CircuitMonkey/synth-stepped-tone-generator/README.md

# synth-stepped-tone-generator
Sound synthesizer circuit for stepped tones. Based on a Forest Mimms III circuit design.
