CircuitMonkey/synth-stepped-tone-generator/Documents/stepped-tone-generator.ods

Stepped Tone Generator |  |  | Rev. A
Part | Value | Device | Package | Description | MFR | MPN | Cost | Have | Cart
FAB |  |  |  |  |  |  | $2.00 |  | Seeed
U1 | NE555P | 555PDIP | DIP-08 | Timer Chip | Tayda | A-249 | $0.15 |  | Tayda
U2 | NE556N | 556PDIP | DIP-14 | 556 Dual Timer | Tayda | A-040 | $0.37 |  | Tayda
U3 | CD4017BE | CD4017PDIP | DIP-16 | CD4017 Decade Counter | Tayda | A-020 | $0.30 |  | Tayda
U1-SKT | 8P |  | DIP-08 | Socket | Tayda | A-001 | $0.05 |  | Tayda
U2-SKT | 14P |  | DIP-14 | Socket | Tayda | A-004 | $0.07 |  | Tayda
U3-SKT | 16P |  | DIP-16 | Socket | Tayda | A-003 | $0.08 |  | Tayda
C1 | 10nF | CAPACITORTHD_5MM | CAP_CER_THD_5MM | Capacitor | Tayda | A-1366 | $0.04 |  | Tayda
C2 | 10nF | CAPACITORTHD_5MM | CAP_CER_THD_5MM | Capacitor | Tayda | A-1366 | $0.04 |  | Tayda
C3 | 10uF | CAPACITORTHD_5MM | CAP_CER_THD_5MM | Capacitor | Tayda | A-3323 | $0.03 |  | Tayda
C4 | 1uF | CAPACITORTHD_5MM | CAP_CER_THD_5MM | Capacitor | Tayda | A-321 | $0.12 |  | Tayda
PWR_AUX | 3P, Male, Breakaway, 2.54mm | CON_03X1-2.54MM-THD-VT | MA03X1 | Header, 3-pin, single row |  |  | $0.06 | Y
D1 | 1N4148 | DIODE-1N4148-THD | DO-35(THD) | Diode |  | A-157 | $0.02 |  | Tayda
D2 | 1N4148 | DIODE-1N4148-THD | DO-35(THD) | Diode |  | A-157 | $0.02 |  | Tayda
D3 | 1N4148 | DIODE-1N4148-THD | DO-35(THD) | Diode |  | A-157 | $0.02 |  | Tayda
D4 | 1N4148 | DIODE-1N4148-THD | DO-35(THD) | Diode |  | A-157 | $0.02 |  | Tayda
SPEAKER | 2inch | Speaker |  | Loudspeaker, 2in |  | A-4117 | $1.00 |  | Tayda
SPEAKER-CON | HDR, 2P | MA02-1VT | MA02-1-FAT | Header, 2-pin |  |  | $0.03 | Y
TRIM1 | 100K | POTRK09?113 | ALPS_RK09D113 | Potentiometer with solder mounts | Alps | A-1851 | $0.70 |  | Tayda
TRIM2 | 100K | POTRK09?113 | ALPS_RK09D113 | Potentiometer with solder mounts | Alps | A-1851 | $0.70 |  | Tayda
TRIM3 | 100K | POTRK09?113 | ALPS_RK09D113 | Potentiometer with solder mounts | Alps | A-1851 | $0.70 |  | Tayda
TRIM4 | 100K | POTRK09?113 | ALPS_RK09D113 | Potentiometer with solder mounts | Alps | A-1851 | $0.70 |  | Tayda
VOLUME | 10K | POTRK09?113 | ALPS_RK09D113 | Potentiometer with solder mounts | Alps | A-1850 | $0.70 |  | Tayda
SPEED | 500K | POTRK09?113 | ALPS_RK09D113 | Potentiometer with solder mounts | Alps | A-1852 | $0.70 |  | Tayda
TONE1 | 500K | POTRK09?113 | ALPS_RK09D113 | Potentiometer with solder mounts | Alps | A-1852 | $0.70 |  | Tayda
TONE2 | 500K | POTRK09?113 | ALPS_RK09D113 | Potentiometer with solder mounts | Alps | A-1852 | $0.70 |  | Tayda
R4 | 470 | RESISTORTHD_0.25_WATT | R_THD_0.25W | Resistor |  | A-2049 | $0.02 |  | Tayda
R1 | 100K | RESISTORTHD_0.25_WATT | R_THD_0.25W | Resistor |  | A-2071 | $0.02 |  | Tayda
R2 | 1K | RESISTORTHD_0.25_WATT | R_THD_0.25W | Resistor |  | A-2123 | $0.02 |  | Tayda
R3 | 1K | RESISTORTHD_0.25_WATT | R_THD_0.25W | Resistor |  | A-2123 | $0.02 |  | Tayda
R5 | 1K | RESISTORTHD_0.25_WATT | R_THD_0.25W | Resistor |  | A-2123 | $0.02 |  | Tayda
R6 | 1K | RESISTORTHD_0.25_WATT | R_THD_0.25W | Resistor |  | A-2123 | $0.02 |  | Tayda
R7 | 1K | RESISTORTHD_0.25_WATT | R_THD_0.25W | Resistor |  | A-2123 | $0.02 |  | Tayda
LED1 | RED | THD3MM | THD_3MM | THD LED |  | A-261 | $0.05 |  | Tayda
LED2 | RED | THD3MM | THD_3MM | THD LED |  | A-261 | $0.05 |  | Tayda
LED3 | RED | THD3MM | THD_3MM | THD LED |  | A-261 | $0.05 |  | Tayda
LED4 | RED | THD3MM | THD_3MM | THD LED |  | A-261 | $0.05 |  | Tayda
PULSE | YEL | THD3MM | THD_3MM | THD LED |  | A-263 | $0.05 |  | Tayda
ON/OFF | SPDT | TOGGLEMTS-102 | MTS-102 | Toggle Switch | Tayda | A-4567 | $0.50 |  | Tayda
PWR | USB Micro-B | USB-B-MICRO-SMTJAE-DX4R005 | JAE-DX4R005 | USB Micro - B-style | JAE | DX4R005JJ2R1800 | $0.70 | Y
 |  |  |  |  |  | Cost: | $11.61
