CircuitMonkey/synth-stepped-tone-generator/PCB/stepped-tone-generator.brd

## EAGLE design PCB/stepped-tone-generator.brd (2021-07-29)

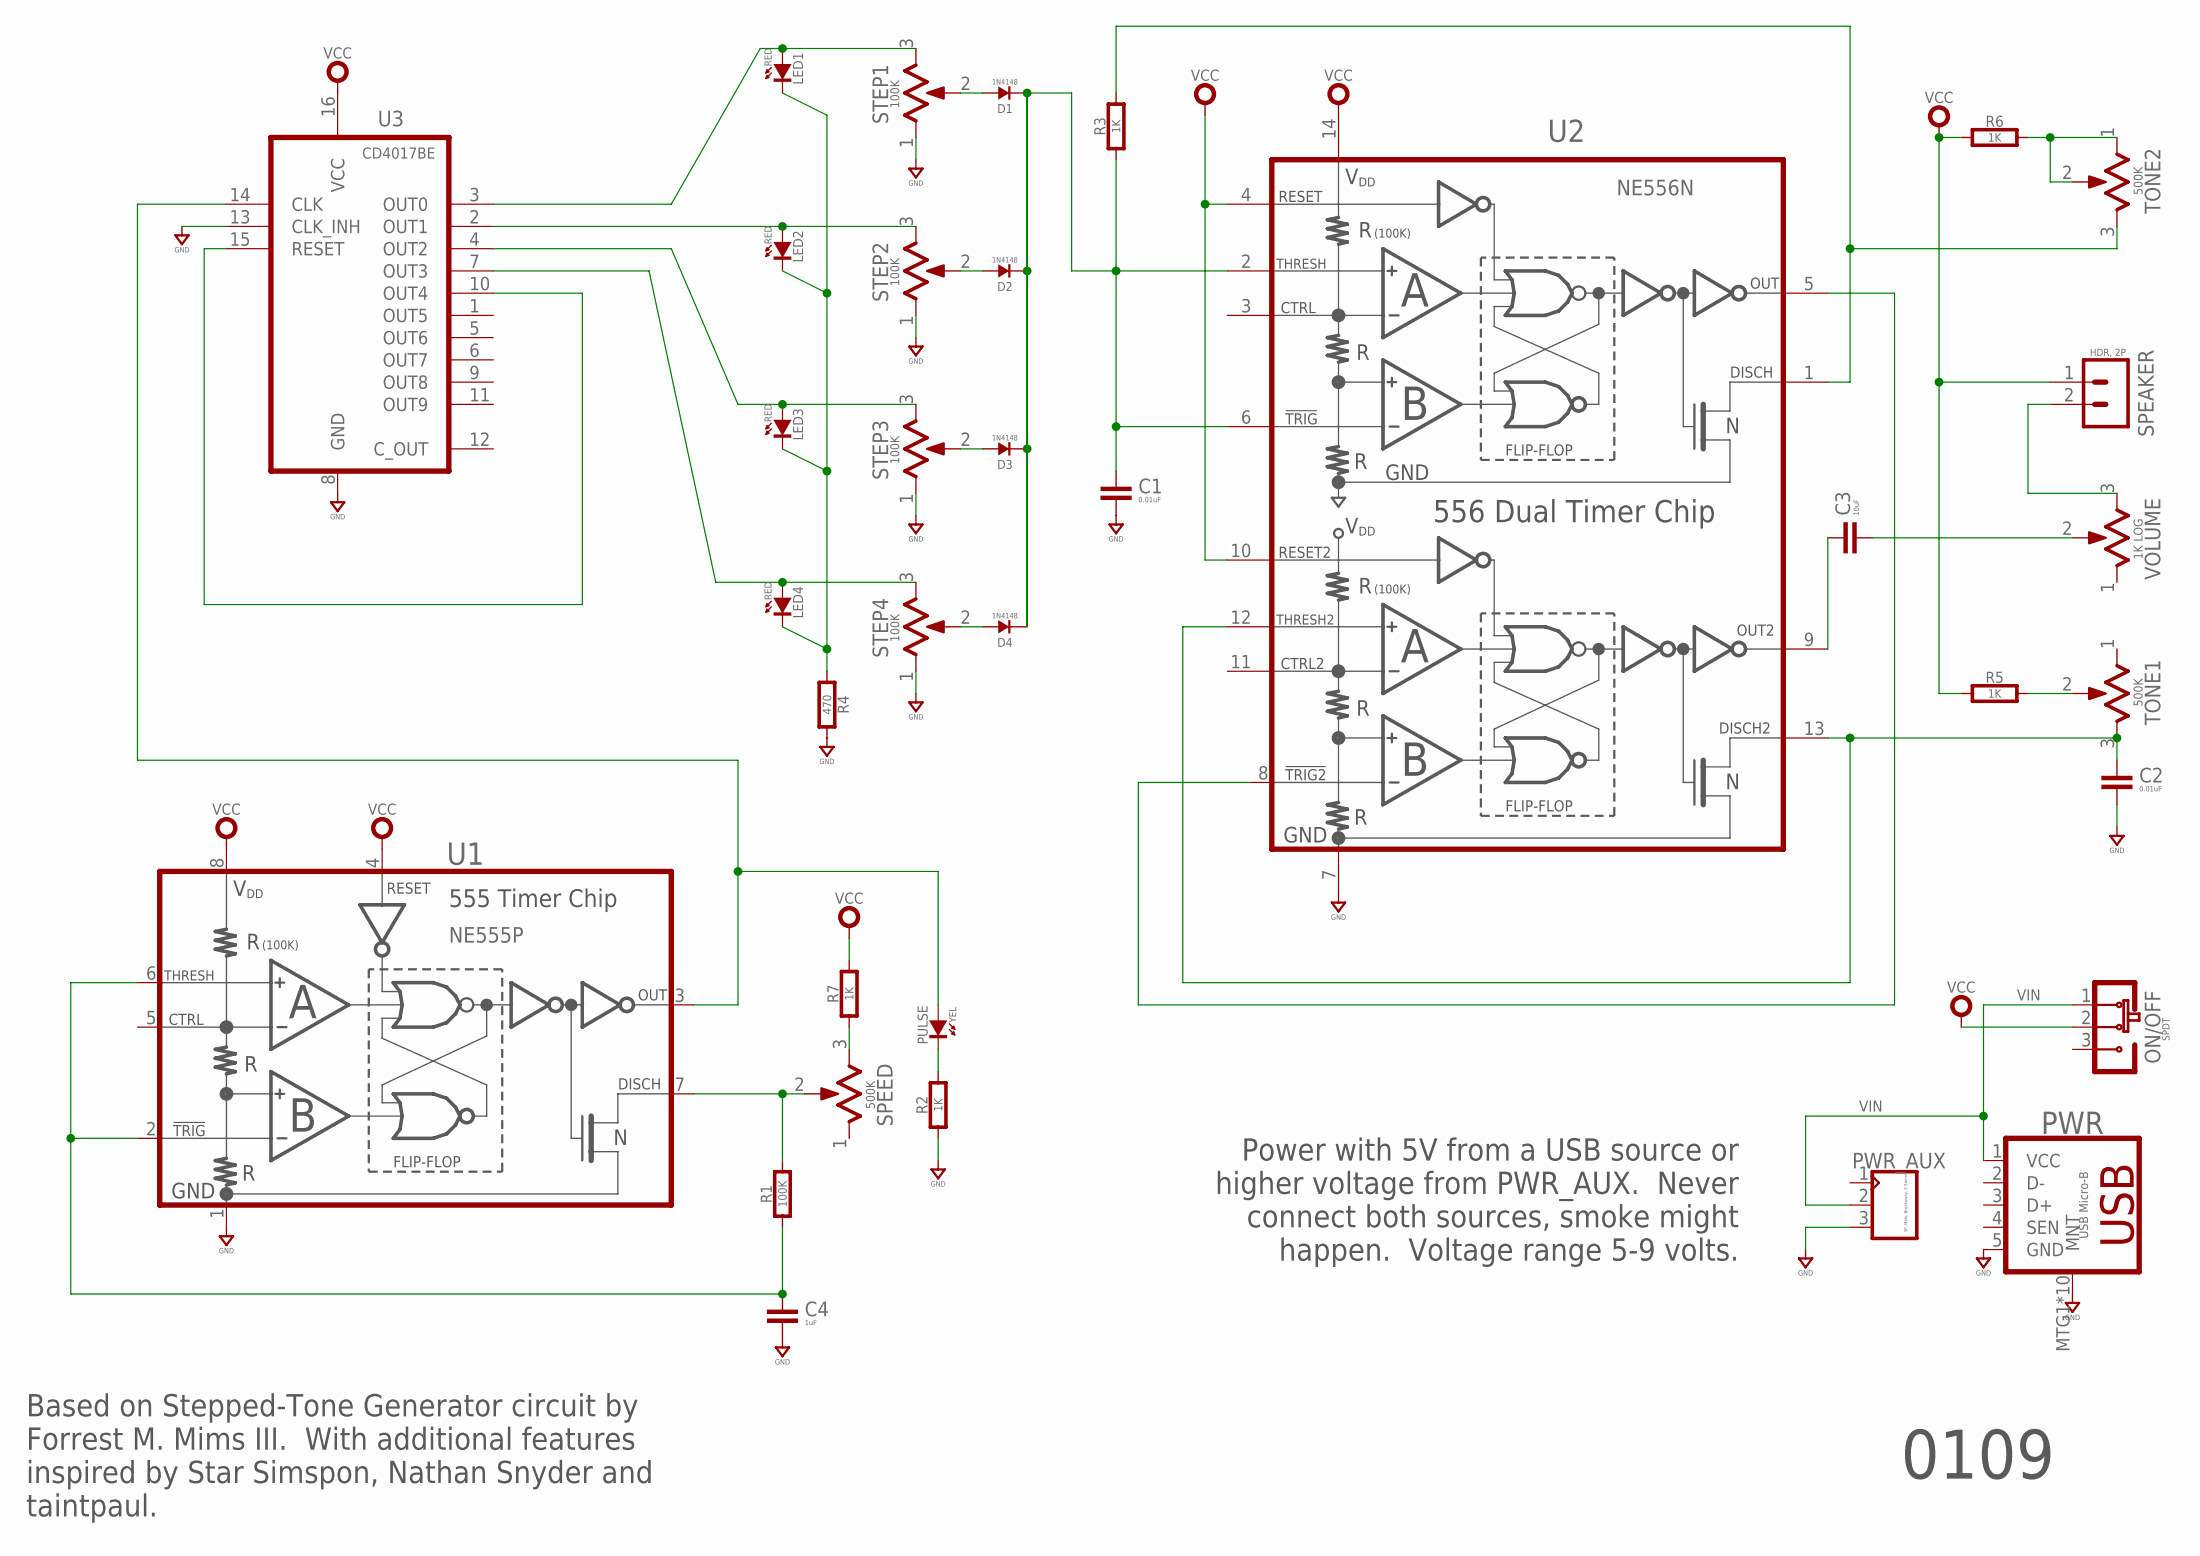
[picture p1: schematic stepped-tone-generator.sch]

Parts:
C1, C2: 0.01uF; CAP_CER_THD_5MM
C3: 10uF; CAP_CER_THD_5MM
C4: 1uF; CAP_CER_THD_5MM
D1, D2, D3, D4: 1N4148; DO-35(THD)
LED1, LED2, LED3, LED4: RED; THD_3MM
ON/OFF: SPDT; MTS-102
PULSE: YEL; THD_3MM
PWR: USB Micro-B; JAE-DX4R005
PWR_AUX: 3P, Male, Breakaway, 2.54mm; MA03X1-VT-THD
R1: 100K; R_THD_0.25W
R2, R3, R5, R6, R7: 1K; R_THD_0.25W
R4: 470; R_THD_0.25W
SPEAKER: HDR, 2P; MA02-1-FAT
SPEED: 500K; ALPS_RK09D113
STEP1, STEP2, STEP3, STEP4: 100K; ALPS_RK09D113
TONE1, TONE2: 500K; ALPS_RK09D113
U1: NE555P; DIP-08
U2: NE556N; DIP-14
U3: CD4017BE; DIP-16
VOLUME: 1K LOG; ALPS_RK09D113

Connections:
GND: C1.2, C2.2, C4.2, PWR.5 (GND), PWR.MTG1 (MNT), PWR.MTG2 (MNT), PWR.MTG3 (MNT), PWR.MTG4 (MNT), PWR.MTG5 (MNT), PWR.MTG6 (MNT), PWR.MTG7 (MNT), PWR.MTG8 (MNT), PWR.MTG9 (MNT), PWR.MTG10 (MNT), PWR_AUX.3, R2.1, R4.1, SPEED.MT1A (GND), SPEED.MT1B (GND), SPEED.MT1C (GND), SPEED.MT2A (GND), SPEED.MT2B (GND), SPEED.MT2C (GND), STEP1.1, STEP1.MT1A (GND), STEP1.MT1B (GND), STEP1.MT1C (GND), STEP1.MT2A (GND), STEP1.MT2B (GND), STEP1.MT2C (GND), STEP2.1, STEP2.MT1A (GND), STEP2.MT1B (GND), STEP2.MT1C (GND), STEP2.MT2A (GND), STEP2.MT2B (GND), STEP2.MT2C (GND), STEP3.1, STEP3.MT1A (GND), STEP3.MT1B (GND), STEP3.MT1C (GND), STEP3.MT2A (GND), STEP3.MT2B (GND), STEP3.MT2C (GND), STEP4.1, STEP4.MT1A (GND), STEP4.MT1B (GND), STEP4.MT1C (GND), STEP4.MT2A (GND), STEP4.MT2B (GND), STEP4.MT2C (GND), TONE1.MT1A (GND), TONE1.MT1B (GND), TONE1.MT1C (GND), TONE1.MT2A (GND), TONE1.MT2B (GND), TONE1.MT2C (GND), TONE2.MT1A (GND), TONE2.MT1B (GND), TONE2.MT1C (GND), TONE2.MT2A (GND), TONE2.MT2B (GND), TONE2.MT2C (GND), U1.1 (GND), U2.7 (GND), U3.8 (GND), U3.13 (CLK_INH), VOLUME.MT1A (GND), VOLUME.MT1B (GND), VOLUME.MT1C (GND), VOLUME.MT2A (GND), VOLUME.MT2B (GND), VOLUME.MT2C (GND)
unnamed: PULSE.A, U1.3 (OUTPUT), U3.14 (CLK)
unnamed: U3.10 (OUT4), U3.15 (RESET)
unnamed: LED1.A, STEP1.3, U3.3 (OUT0)
unnamed: LED2.A, STEP2.3, U3.2 (OUT1)
unnamed: LED3.A, STEP3.3, U3.4 (OUT2)
unnamed: LED4.A, STEP4.3, U3.7 (OUT3)
unnamed: R5.2, TONE1.2
unnamed: R3.2, TONE2.3, U2.1 (DISCHARGE)
unnamed: C3.1, U2.9 (OUTPUT2)
unnamed: C2.1, TONE1.3, U2.12 (THRESHOLD2), U2.13 (DISCHARGE2)
unnamed: U2.5 (OUTPUT), U2.8 (TRIGGER2#)
unnamed: C4.1, R1.1, U1.2 (TRIGGER#), U1.6 (THRESHOLD)
unnamed: LED1.K (C), LED2.K (C), LED3.K (C), LED4.K (C), R4.2
unnamed: R1.2, SPEED.2, U1.7 (DISCHARGE)
unnamed: PULSE.K (C), R2.2
unnamed: D1.A, STEP1.2
unnamed: D2.A, STEP2.2
unnamed: D3.A, STEP3.2
unnamed: D4.A, STEP4.2
unnamed: C1.1, D1.K, D2.K, D3.K, D4.K, R3.1, U2.2 (THRESHOLD), U2.6 (TRIGGER#)
unnamed: C3.2, VOLUME.2
unnamed: R7.1, SPEED.3
unnamed: R6.2, TONE2.1, TONE2.2
unnamed: SPEAKER.2, VOLUME.3
VCC: ON/OFF.2, R5.1, R6.1, R7.2, SPEAKER.1, U1.4 (RESET#), U1.8 (VDD), U2.4 (RESET#), U2.10 (RESET2), U2.14 (VDD), U3.16 (VCC)
VIN: ON/OFF.1, PWR.1 (VCC), PWR_AUX.2

Notes on the sheet:
Based on Stepped-Tone Generator circuit by Forrest M. Mims III. With additional features inspired by Star Simspon, Nathan Snyder and taintpaul.
Power with 5V from a USB source or higher voltage from PWR_AUX. Never connect both sources, smoke might happen. Voltage range 5-9 volts.
0109

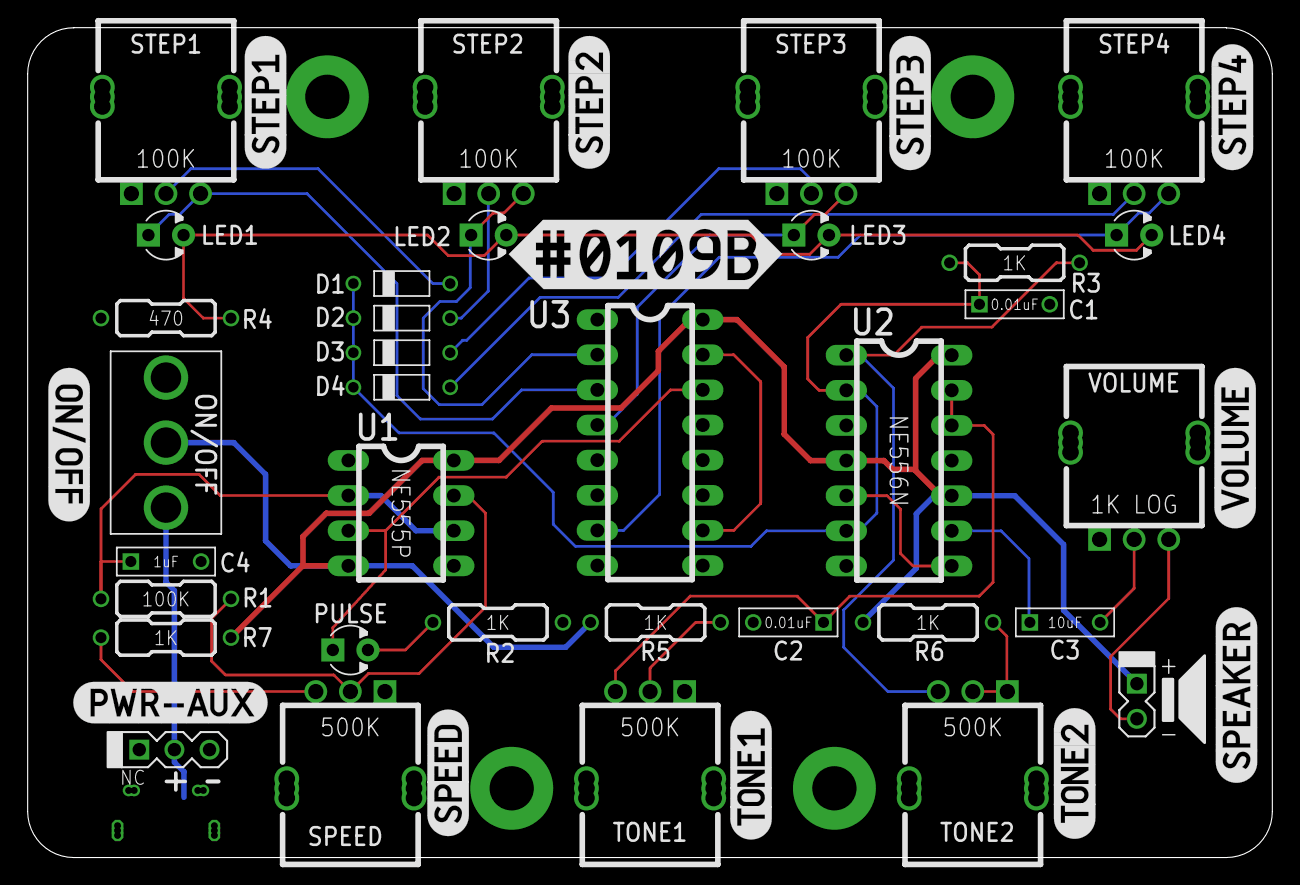
[picture p2: board stepped-tone-generator.brd from above]

Board: 2 copper layers, 90.0 x 60.0 mm, 35 parts (1 on the bottom side), 27 nets.
