CircuitMonkey/synth-stepped-tone-generator/(commit log)

2021-01-31 Rev. A
    [stepped-tone-generator.brd, stepped-tone-generator.ods, stepped-tone-generator.sch]
2021-03-18 Update stepped-tone-generator.ods
    Update BOM
    [stepped-tone-generator.ods]
2021-03-21 Made PCB larger. Set proper values for pots.
    [stepped-tone-generator.brd, stepped-tone-generator.sch]
2021-03-22 Added labels for pots.
    [stepped-tone-generator.brd, stepped-tone-generator.sch]
2021-07-29 Stepped tone generator fixes
    [stepped-tone-generator.brd, stepped-tone-generator.sch]
